hhintoglu/Note_Controlled_Vehicle/README.md

# Note_Controlled_Vehicle
Repo for Note Controlled Vehicle project
