hhintoglu/Note_Controlled_Vehicle/LTspice/Band-Pass1.asc

C1: cap; 1nF
C2: cap; 1nF
R2: res; 10k
R3: res; 100k
R6: res; 100k
Rf1: res; 50k
Rf: res; 50k
Rg: res; 79k
RQ: res; 258
U1: UniversalOpamp2
U2: UniversalOpamp2
U3: UniversalOpamp2
V1: voltage; -12v
V2: voltage; 12v
V3: voltage; -12v
V4: voltage; -12v
V5: voltage; 12v
V6: voltage; 12v
V7: voltage; PULSE(0 5 0 1p 1p 0.5m 1m); AC 1
Named nets: 0
.tran 0.05
;ac dec 5 10 10k
