hhintoglu/Note_Controlled_Vehicle/LTspice/Band-Pass2.asc

C1: cap; 1µf
C2: cap; 1µF
R3: res; 10k
RB: res; 32k
Rf1: res; 10k
Rf2: res; 161
RF: res; 161
Rg1: res; 3.2k
U1: UniversalOpamp2
U2: UniversalOpamp2
U3: UniversalOpamp2
V1: voltage; -12v
V2: voltage; 12v
V3: voltage; -12v
V4: voltage; -12v
V5: voltage; 12v
V6: voltage; 12v
V7: voltage; PULSE(0 5 0 1p 1p 0.8m 1.6m); AC 1
Named nets: 0
.tran 0 1.15 1
;ac dec 5 10 20k
