hhintoglu/Note_Controlled_Vehicle/LTspice/Might-be-this-one.asc

1: res; 8
C1: cap; 100n
C2: cap; 100n
C3: cap; 100n
C4: cap; 100n
C6: cap; 100n
C7: cap; 100n
C8: cap; 100n
C9: cap; 100n
C10: cap; 100n
C11: cap; 100n
C12: cap; 100n
C13: cap; 100n
C14: cap; 10µ
C15: cap; 10µ
C16: cap; 10µ
D1: diode
D2: diode
D3: diode
D4: diode
D5: diode
D9: diode
D10: diode
Q1: pnp; BC557C
Q2: npn; BC547C
Q3: npn
Q4: pnp
Q13: pnp; BC557C
Q14: npn; BC547C
Q17: npn
Q18: pnp
R1: res; 160k
R2: res; 320k
R3: res; 160k
R4: res; 320k
R5: res; 8
R6: res; 1k
R7: res; 300k
R8: res; 300k
R9: res; 600k
R10: res; 15
R11: res; 300k
R12: res; 600k
R13: res; 15
R14: res; 228k
R15: res; 456k
R16: res; 11
R17: res; 228k
R18: res; 456k
R19: res; 11
R20: res; 560
R21: res; 560
R22: res; 1k
R23: res; 100k
R24: res; 100k
R25: res; 10k
R26: res; 10k
R27: res; 10k
R28: res; 1k
R29: res; 1k
R32: res; 1k
R34: res; 15k
R36: res; 1k
R46: res; 560
R47: res; 560
R48: res; 1k
R49: res; 100k
R50: res; 100k
U1: UniversalOpamp2
U2: UniversalOpamp2
U3: UniversalOpamp2
U4: UniversalOpamp2
U5: UniversalOpamp2
U6: UniversalOpamp2
U7: UniversalOpamp2
U8: UniversalOpamp2
U9: UniversalOpamp2
U10: UniversalOpamp2
U11: UniversalOpamp2
U12: UniversalOpamp2
V1: voltage; 1
V2: voltage; 12
V3: voltage; -12
V4: voltage; SINE(0 0.03 523); AC 1
Named nets: 0, -Vcc, Vcc, Vcc2
698 Left Way
523 Straight
987 Right Way
.tran 0 1.3 1
;tran 100ms
