hhintoglu/Note_Controlled_Vehicle/LTspice/Second-attempt.asc

C0: cap; 1µF
C1: cap; 50nF
C2: cap; 50nF
C3: cap; 10µ
C4: cap; 72n
C5: cap; 72n
C6: cap; 10µ
C7: cap; 96n
C8: cap; 96n
C9: cap; 10µ
Ce: cap; 22µF
Ci: cap; 1µF
D1: diode
D2: diode
D3: diode
L1: ind; 0.1
L2: ind; 0.1
L3: ind; 0.1
Q1: npn
Q2: npn
Q3: npn
Q4: npn
R1: res; 47k
R2: res; 8k
R3: res; 1k
R4: res; 10k
R5: res; 10k
R6: res; 1k
R7: res; 1
R8: res; 1k
R9: res; 10k
R10: res; 10k
R11: res; 1k
R12: res; 1
R13: res; 1k
R14: res; 10k
R15: res; 10k
R16: res; 1k
R17: res; 1
Rc: res; 4.7k
Re: res; 1k
RL: res; 10k
U1: UniversalOpamp2
U2: UniversalOpamp2
U3: UniversalOpamp2
U4: UniversalOpamp2
U5: UniversalOpamp2
U6: UniversalOpamp2
U7: UniversalOpamp2
V1: voltage; -12
V2: voltage; -12
V3: voltage; -12
V4: voltage; -12
V5: voltage; 11
V6: voltage; 5
V7: voltage; 5
V8: voltage; 12
V9: voltage; -12
V10: voltage; -12
V11: voltage; 10.5
V12: voltage; 5
V13: voltage; 5
V14: voltage; 12
V15: voltage; -12
V16: voltage; -12
V17: voltage; 9.5
V18: voltage; 5
V19: voltage; 5
V20: voltage; 12
Vcc: voltage; 20
Vi: voltage; PULSE(0 0.02 0 1p 1p 1m 2m)
Named nets: 0
.tran 100m
Experiment 8 - Question 3
Recep Günay - 2093888
