hhintoglu/Note_Controlled_Vehicle/LTspice/The_final_circuit.asc

C1: cap; 100n
C2: cap; 100n
C3: cap; 100n
C4: cap; 100n
C5: cap; 22µ
C6: cap; 100n
C7: cap; 100n
C8: cap; 100n
C9: cap; 100n
C10: cap; 100n
C11: cap; 100n
C12: cap; 100n
C13: cap; 100n
C14: cap; 10µ
C15: cap; 10µ
C16: cap; 10µ
D1: diode
D2: diode
D3: diode
D4: diode
D5: diode
D6: diode
D7: diode
L1: ind; 0.1
L2: ind; 0.1
Microphone: res; 1
Q1: npn
Q2: npn
Q3: npn
Q4: npn
R1: res; 6.2k
R2: res; 49.5k
R3: res; 6.2k
R4: res; 49.5k
R5: res; 54.5
R6: res; 1k
R7: res; 17k
R8: res; 11.3k
R9: res; 90.45k
R10: res; 103.1
R11: res; 11.3k
R12: res; 90.45k
R13: res; 103.1
R14: res; 8.8k
R15: res; 70.5k
R16: res; 76.6
R17: res; 8.8k
R18: res; 70.5k
R19: res; 76.6
R20: res; 1k
R21: res; 1k
R22: res; 1k
R23: res; 1k
R24: res; 1k
R25: res; 10k
R26: res; 10k
R27: res; 10k
R28: res; 1k
R29: res; 1k
R30: res; 1k
R31: res; 1k
R32: res; 1k
R33: res; 10k
R34: res; 1k
R35: res; 470
R36: res; 1k
R37: res; 10
R38: res; 470
R39: res; 10
R40: res; 10k
R44: res; 10k
Rg: res; 54.5
U1: UniversalOpamp2
U2: UniversalOpamp2
U3: UniversalOpamp2
U4: UniversalOpamp2
U5: UniversalOpamp2
U6: UniversalOpamp2
U7: UniversalOpamp2
U8: UniversalOpamp2
U9: UniversalOpamp2
U10: UniversalOpamp2
U11: UniversalOpamp2
U12: UniversalOpamp2
U13: UniversalOpamp2
U14: UniversalOpamp2
U15: UniversalOpamp2
U16: UniversalOpamp2
V2: voltage; 12
V3: voltage; -12
V4: voltage; SINE(0 0.02 1300); AC 1
Named nets: 0, -Vcc, Vcc
698 Left Way
523 Straight
987 Right Way
.tran 0 1.007 1
Output of the left part
Output of the summing amplifier
Output of the right part
FILTER
AMPLIFICATION
MICROPHONE
RECEIVER UNIT
AC TO DC
DECODING PART
DECISION SUBUNIT
FUNCTION SUBUNIT
CONTROL UNIT
;ac lin 1000 10 2000
