hhintoglu/Note_Controlled_Vehicle/LTspice/This-is-the-one_Ver2.asc

C1: cap; 100n
C2: cap; 100n
C3: cap; 100n
C4: cap; 100n
C5: cap; 22µF
C6: cap; 100n
C7: cap; 100n
C8: cap; 100n
C9: cap; 100n
C10: cap; 100n
C11: cap; 100n
C12: cap; 100n
C13: cap; 100n
C14: cap; 10µ
C15: cap; 10µ
C16: cap; 10µ
D1: diode
D2: diode
D3: diode
D4: diode
D5: diode
D6: diode
D7: diode
Left_Motor: res
Q1: npn; BC547C
Q2: npn; BC547C
Q3: npn; BC547C
Q4: npn; BC547C
R1: res
R2: res
R3: res
R4: res
R5: res
R6: res; 1k
R7: res; 100k
R8: res
R9: res
R10: res
R11: res
R12: res
R13: res
R14: res
R15: res
R16: res
R17: res
R18: res
R19: res
R20: res; 2k
R21: res; 1k
R22: res; 1k
R23: res
R24: res; 2k
R25: res; 10k
R26: res; 10k
R27: res; 10k
R28: res; 1k
R29: res; 1k
R30: res; 1k
R31: res; 2k
R32: res; 10k
R33: res; 10k
R34: res; 470
R35: res; 470
R36: res; 1k
R37: res
Right_Motor: res
U1: UniversalOpamp2
U2: UniversalOpamp2
U3: UniversalOpamp2
U4: UniversalOpamp2
U5: UniversalOpamp2
U6: UniversalOpamp2
U7: UniversalOpamp2
U8: UniversalOpamp2
U9: UniversalOpamp2
U10: UniversalOpamp2
U11: UniversalOpamp2
U12: UniversalOpamp2
U13: UniversalOpamp2
U14: UniversalOpamp2
U15: UniversalOpamp2
V2: voltage; 12
V3: voltage; -12
V4: voltage; SINE(0 0.03 698); AC 1
Named nets: 0, -Vcc, Vcc
698 Left Way
523 Straight
987 Right Way
.tran 0 1.6 1
Output of the left part
Output of the summing amplifier
Output of the right part
FILTER
AMPLIFICATION
MICROPHONE
RECEIVER UNIT
AC TO DC
DECODING PART
DECISION SUBUNIT
FUNCTION SUBUNIT
CONTROL UNIT
